ImproverX/RW-player/README.md

# RW-player

Плеер на Ардуино для ПК Вектор-06ц, может воспроизводить файлы в форматах ROM, MDOS, MON, ASM, BAS (CLOAD), BAS (BLOAD), CAS, VKT, записывать данные с ПК Вектор-06ц в любом формате вывода. Формат вывода определяется по расширению файла, некоторые неочевидные моменты:
- <файл>.r0m или <файл>.r00 -- воспроизведение в формате ROM с нулевого блока (<файл>.r2F -- с блока № 2Fh и т.п.)
- <файл>.mon или <файл>.m01 -- воспроизведение в формате MON с загрузкой по адресу 0100h, <файл>.m80 -- по адресу 8000h, аналогично задаётся адрес начальной загрузки для формата BAS (BLOAD), например <файл>.bA8 будет загружен с адреса A800h.

Управление кнопками, старт воспроизведения по нажатию "стрелки вправо" после выбора файла, нажатие "select" -- воспроизведение любых файлов в формате MDOS. При воспроизведении в формате MDOS файлов с расширением .rom они будут автоматически переименованы в <файл>.com.

Для сборки потребуется "Arduino UNO" (или аналог), "LCD Keypad Shield" и "Data Logger Shield", на котором нужно подпаять немного обычных сопротивлений и конденсаторов для входа и выхода. Никаких специфических плат или специнструментов не потребуется, все компоненты легко найти.

Для компиляции дополнительно к стандартным требуются библиотеки:
- RTClib (от Adafruit, библиотека TinyWireM не обязательна)
- SdFat (от Bill Greiman)
- TimerOne (от Paul Stoffregen)

## Схема подключений:
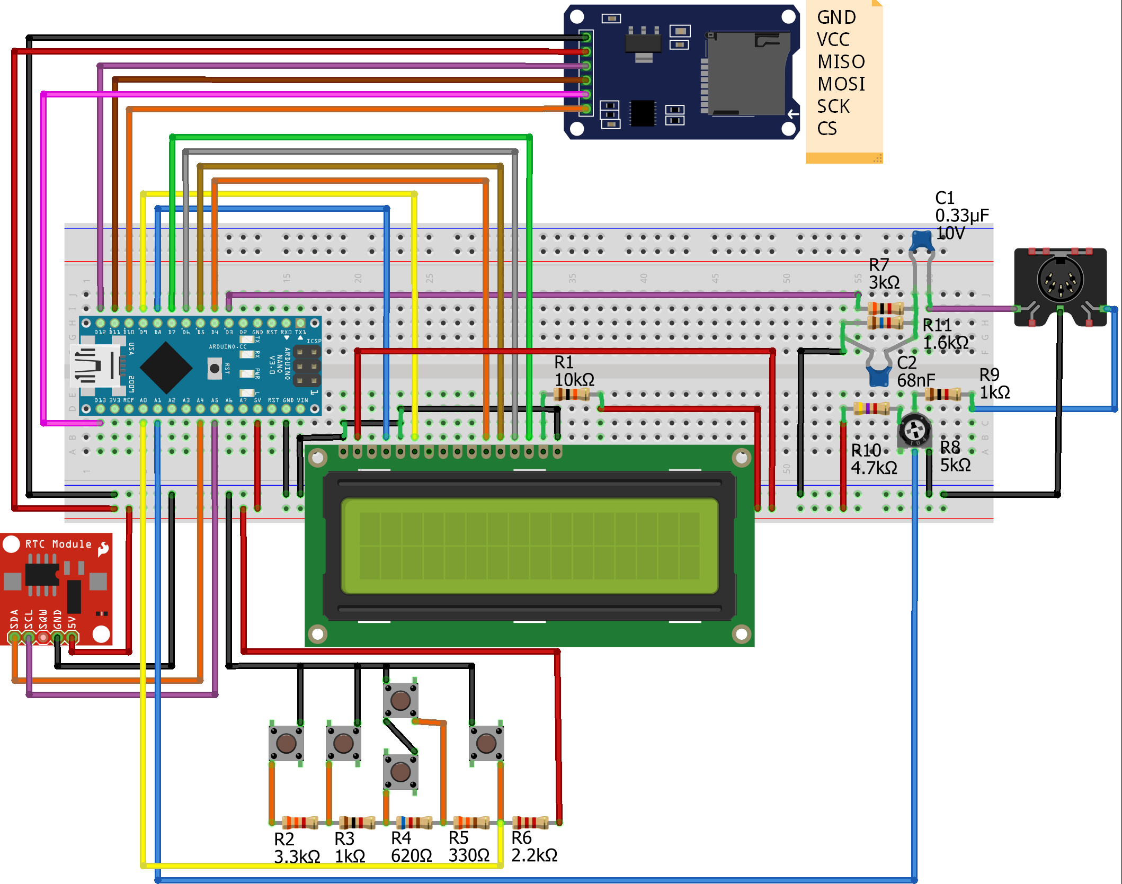
[picture p1: RW-player_circiut.png]
Circuit
<br>

* Выход - D3
* Вход  - A1

"Data Logger Shield V1.0":<br>
SD-картридер подключен к выводам ардуино:
* MOSI - D11
* MISO - D12
* CLK  - D13
* CS   - D10

Часы реального времени (RTC DS1307) подключены:
* SDA  - A4
* SDL  - A5

"LCD Keypad Shield":
Подключение экрана 1602А:
* LCD RS pin     - D8
* LCD Enable pin - D9
* LCD D4 pin     - D4
* LCD D5 pin     - D5
* LCD D6 pin     - D6
* LCD D7 pin     - D7
* LCD R/W pin    - GND
* LCD 5V pin     - 5V
* Подсветка      - D10
* Кнопки         - A0

## Пример сборки:
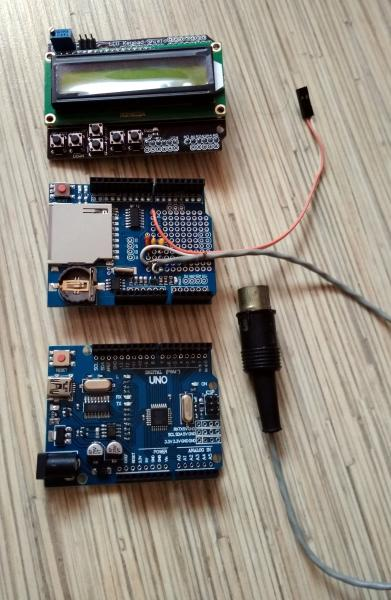
[picture p2: Photo_1.jpg]
Player1
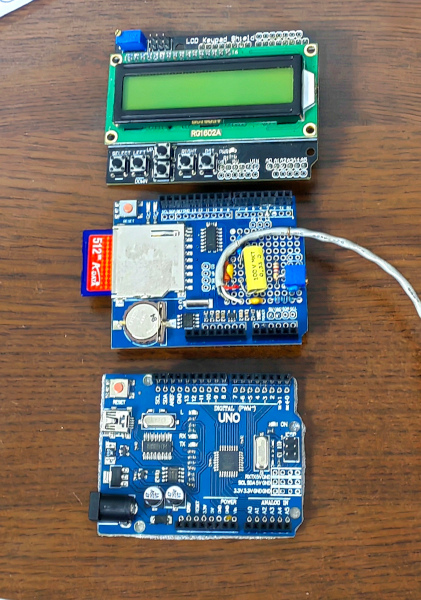
[picture p3: Photo_3.jpg]
Player3
  
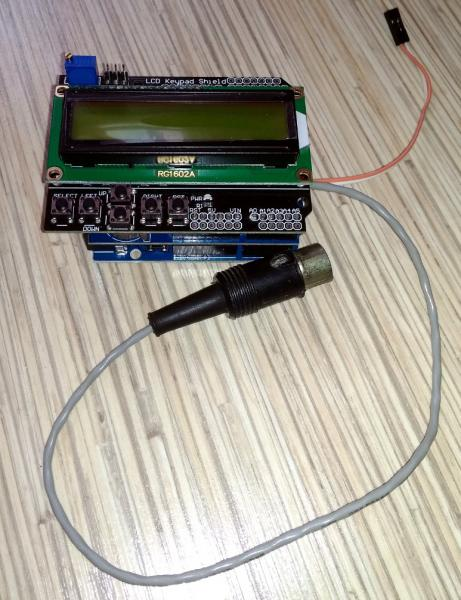
[picture p4: Photo_2.jpg]
Player2


[More info (russian)...](https://zx-pk.ru/threads/28819-rom-pleer-na-arduino.html?p=1073624&viewfull=1#post1073624)
